uperez-unis/Ecualizador-de-6-bandas/Documentación/Ecualizador Reporte.pdf

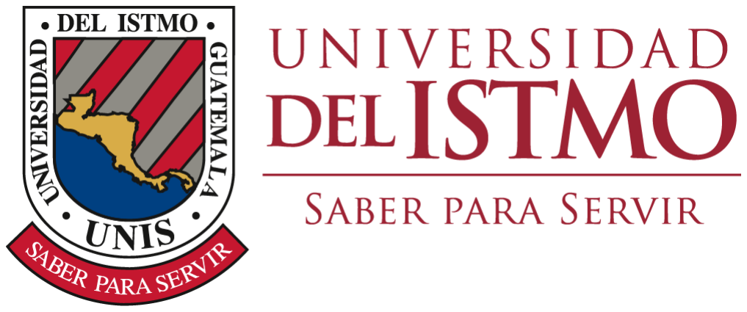
[picture p2: figure]

Microelectronic Devices
Pablo Oliva

# Ecualizador para piano eléctrico

Diego Alejandro Lemus Aldana Uriel Esaú Pérez Morales Diego Solís

## Contents

1 Introducción | 2
2 Instrumento: Piano Eléctrico | 2
3 Arquitectura del sistema | 2
4 Bandas de frecuencia | 2
5 Construcción de los Filtros Pasabanda | 3
6 Simulación en LTspice y Análisis del Ancho de Banda | 4
7 Diseño de Pasa-Bandas Sallen Key | 6
8 Determinación de límites de ganancia del sistema | 8
9 Diseño de sumador inversor para ±12 dB | 10
10 Simulación de sumador inversor en LTspice | 13

## 1 Introducción

El presente proyecto consiste en el diseño e implementación de un ecualizador analógico de seis bandas, desarrollado específicamente para un piano eléctrico. El sistema permite la amplificación o atenuación independiente de cada rango de frecuencia, con el objetivo de moldear el timbre del instrumento según las necesidades del intérprete.
La arquitectura del sistema se divide en cuatro etapas principales. La primera corresponde a la etapa de acople con el instrumento, implementada mediante un seguidor de voltaje para garantizar alta impedancia de entrada y evitar la pérdida de señal. La segunda etapa está compuesta por seis filtros pasabanda, construidos a partir de la combinación de filtros pasa-altas y pasa-bajas de segundo orden utilizando la topología Sallen-Key [1]. Posteriormente, las señales filtradas son sumadas en una etapa de amplificación tipo sumador, que permite el control individual de ganancia por banda. Finalmente, la señal procesada es enviada a una etapa de potencia encargada de excitar el sistema de salida.

## 2 Instrumento: Piano Eléctrico

## 3 Arquitectura del sistema

El ecualizador diseñado se compone de cuatro etapas funcionales claramente definidas, las cuales permiten el procesamiento progresivo de la señal desde su acople con el instrumento hasta su entrega final a la etapa de potencia.

1. Etapa de acople (Buffer de entrada). Implementada mediante un seguidor de voltaje, esta etapa proporciona alta impedancia de entrada y baja impedancia de salida, evitando la carga del instrumento y preservando la integridad de la señal original.
2. Etapa de filtrado. Cada banda del ecualizador se construye a partir de la cascada de un filtro pasa-altas y un filtro pasa-bajas de segundo orden, ambos implementados mediante la topología Sallen-Key. Esta configuración permite obtener un filtro pasabanda de cuarto orden para cada rango de frecuencia definido.
3. Etapa de control de ganancia. Las salidas de cada banda son enviadas a un circuito sumador activo, donde se implementa el control independiente de atenuación o amplificación mediante potenciómetros. En esta etapa también se incorpora el control general de volumen del sistema.
4. Etapa de potencia. Finalmente, la señal procesada es aplicada a una etapa de potencia basada en transistores BJT en configuración clase AB, permitiendo la entrega adecuada de corriente hacia la carga de salida (bocina 8 ohm).

## 4 Bandas de frecuencia

El espectro útil del piano eléctrico se concentra aproximadamente entre 40 Hz y 6 kHz. Para lograr un control tonal balanceado, se definieron seis bandas de frecuencia estratégicamente distribuidas, permitiendo modificar profundidad, cuerpo, claridad y brillo del instrumento sin generar solapamientos excesivos.

### 4.1 Definición inicial con criterio musical

Banda | Rango (Hz) | Justificación Técnica y Musical
1 | 40 – 80 | Controla la profundidad de las notas graves. Influye en la sensación de peso y potencia del instrumento. Un exceso puede generar saturación o sonido poco definido.
2 | 80 – 200 | Región del cuerpo principal del piano. Permite ajustar calidez y evitar efecto “boomy”.
3 | 200 – 500 | Zona crítica donde puede aparecer efecto de sonido “en-cajonado”. Un ajuste adecuado mejora la claridad.
4 | 500 – 1500 | Determina la definición y presencia del instrumento en mezcla. Fundamental para inteligibilidad.
5 | 1500 – 3000 | Contiene el ataque del martillo. Ajusta articulación y percepción de detalle.
6 | 3000 – 8000 | Controla brillo y armónicos superiores. Aporta claridad y aire al sonido.

Table 1: Rangos de frecuencia definidos con criterio musical.

### 4.2 Frecuencia central calculada (media geométrica)

En filtros pasa-banda, la frecuencia central se define como:

f0 =

p
fLfH. | (1)
Banda | fL (Hz) | fH (Hz) | f0 = fLfH (Hz)
1 | 40 | 80 | 56.6 ≈ 57
2 | 80 | 200 | 126.5 ≈ 127
3 | 200 | 500 | 316.2 ≈ 316
4 | 500 | 1500 | 866.0 ≈ 886
5 | 1500 | 3000 | 2121.3 ≈ 2121
6 | 3000 | 8000 | 4899 ≈ 4900

√

Table 2: Frecuencias centrales calculadas mediante media geométrica.

## 5 Construcción de los Filtros Pasabanda

Cada banda del ecualizador se implementa mediante la combinación de tres bloques principales:

- Filtro pasa-altas de segundo orden (HP2).
- Filtro pasa-bajas de segundo orden (LP2).
- Etapa de amplificación con control de ganancia.

Los filtros HP2 y LP2 se conectan en configuración en cascada, de modo que la salida del filtro pasa-altas alimenta directamente la entrada del filtro pasa-bajas. Esta configuración genera un filtro pasabanda equivalente de cuarto orden.
Dado que cada etapa es de segundo orden, el sistema presenta una pendiente de atenuación de aproximadamente −40 dB/dec tanto en la región inferior como en la superior fuera de la banda de paso, proporcionando una adecuada selectividad para el control independiente de cada rango del ecualizador.
Para el diseño de cada etapa se adopta una respuesta Butterworth de segundo orden, caracterizada por el siguiente factor de calidad:
Q ≈ 0.707 | (2)

Este valor garantiza una respuesta de magnitud máximamente plana en la banda de paso, sin ondulaciones y con una atenuación de −3 dB en la frecuencia de corte [2].
La ganancia de las etapas de filtrado será unitaria (K = 1), de modo que el control de nivel por banda se realice en una etapa independiente posterior al filtrado.

## 6 Simulación en LTspice y Análisis del Ancho de Banda

### 6.1 Caso inicial: 1 octava (40–80 Hz)

Para la primera banda se establecieron:

fL = 40 Hz, | fH = 80 Hz. | (3)

Al realizar la simulación en LTSpice se observó que la magnitud máxima del pasabanda no alcanzaba 0 dB, sino aproximadamente −1.78 dB.

### 6.2 Análisis individual de cada etapa en la frecuencia central

Para esta banda:

f0 =

√
40 · 80 = 56.6 Hz. | (4)

Al evaluar cada filtro por separado en f0, se obtuvo:

- Filtro pasa-altas: −0.917 dB
- Filtro pasa-bajas: −0.862 dB

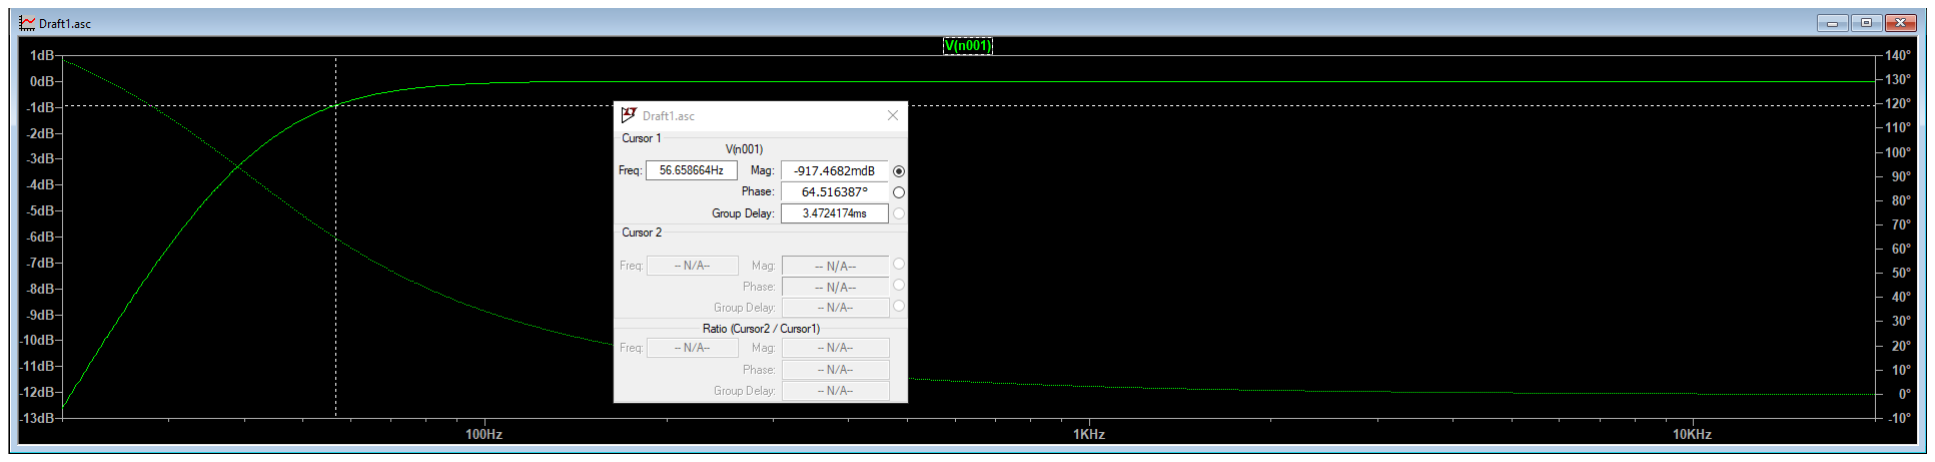
[picture p3: figure]

Figure 1: Respuesta en frecuencia del filtro pasa-altas en f0 = 56.6 Hz.

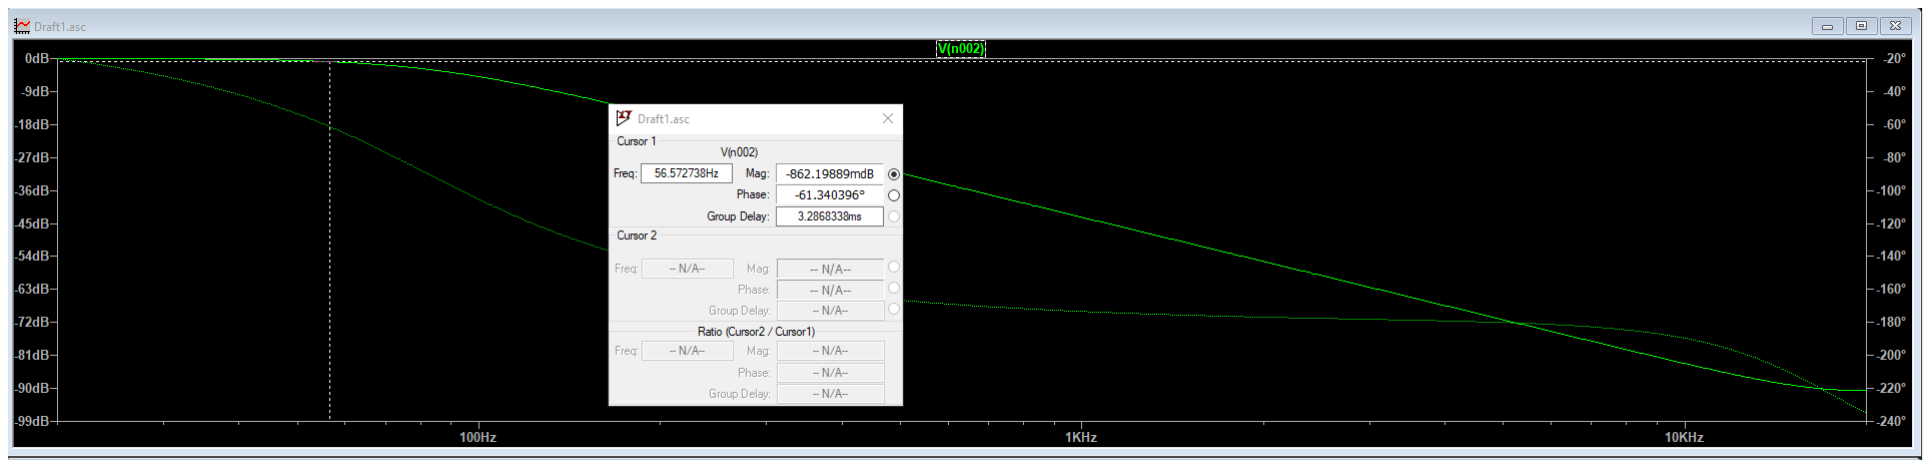
[picture p4: figure]

Figure 2: Respuesta en frecuencia del filtro pasa-bajas en f0 = 56.6 Hz.

Dado que ambas etapas se encuentran en cascada:

Htotal(jω) = HHP (jω) · HLP (jω). | (5)

Al expresarse en decibeles, el producto en magnitud se convierte en una suma logarítmica, por lo que:

Gtotal ≈ −0.917 dB + (−0.862 dB) ≈ −1.78 dB. | (6)

### 6.3 Corrección mediante 2 octavas

Para aumentar la separación entre frecuencias de corte, se utilizó un ancho de banda de dos octavas:

fL =

f0
2
, | fH = 2f0. | (7)

Con f0 ≈ 57 Hz:

fL = 28.3 Hz, | fH = 113.1 Hz. | (8)
Parámetro | Caso 1 octava | Caso 2 octavas
fL (Hz) | 40 | 28.5
fH (Hz) | 80 | 114
f0 (Hz) | 56.6 | 57

Table 3: Comparación de frecuencias para 1 octava vs 2 octavas (Banda 1).

Con esta configuración, la frecuencia central se ubica más lejos de las regiones de transición de ambas etapas, reduciendo la atenuación observada a aproximadamente −0.45 dB.

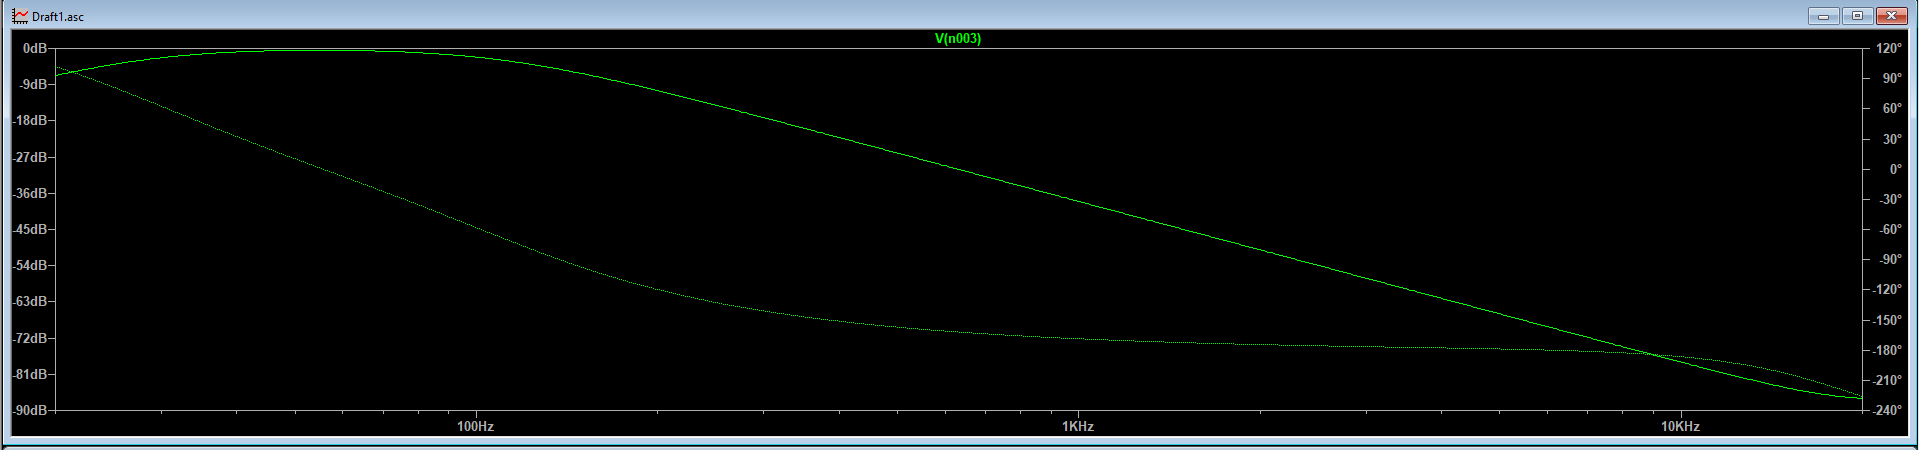
[picture p5: figure]

Figure 3: Respuesta del filtro pasa-banda utilizando un ancho de dos octavas.

A partir de este resultado, la misma estrategia será aplicada al diseño de las bandas restantes del ecualizador.

### 6.4 Frecuencias de corte calculadas para un ancho de dos octavas

Con el objetivo de aumentar la separación entre las frecuencias de corte y reducir la atenuación en la frecuencia central, se redefinió el ancho de banda utilizando dos octavas alrededor de f0.
Las nuevas frecuencias de corte se calcularon mediante:

fL =

f0
2
, | fH = 2f0. | (9)

De esta manera, la frecuencia central permanece constante, pero se incrementa la distancia relativa respecto a las regiones de transición de cada etapa.
Los valores obtenidos para cada banda se presentan en la Tabla 4.
Banda | fL (Hz) | fH (Hz) | f0 (Hz)
1 | 28.5 | 114 | 57
2 | 63.5 | 254 | 127
3 | 158 | 632 | 316
4 | 443 | 1772 | 886
5 | 1060.5 | 4242 | 2121
6 | 2450 | 9800 | 4900

Table 4: Frecuencias de corte calculadas utilizando un ancho de dos octavas alrededor de f0.

Estos valores serán utilizados para el diseño de los filtros pasa-altas (HP2) y pasa-bajas (LP2) correspondientes a cada banda del ecualizador.

## 7 Diseño de Pasa-Bandas Sallen Key

En las siguientes figuras se presentan las estructuras correspondientes a los filtros pasa-altas (HP2) y pasa-bajas (LP2) de segundo orden implementados mediante la topología Sallen-Key, para llevar a cabo la construcción de cada banda del ecualizador.

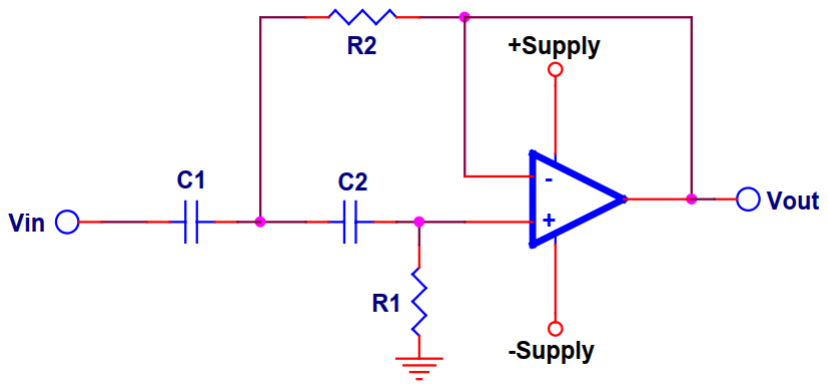
[picture p6: figure]

Figure 4: Estructura Sallen-Key para filtro pasa-altas de segundo orden.

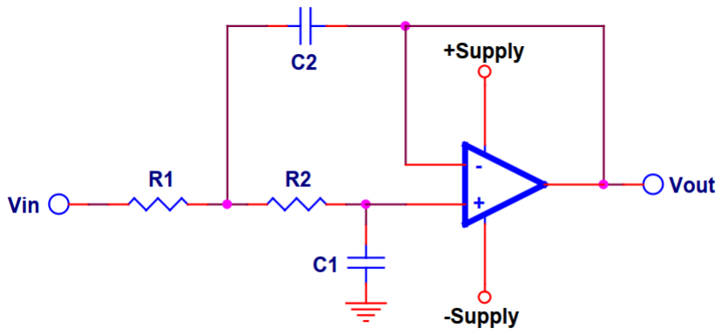
[picture p7: figure]

Figure 5: Estructura Sallen-Key para filtro pasa-bajas de segundo orden.

A partir de las frecuencias de corte fL y fH presentadas en la Tabla 4, se configuró cada filtro con una respuesta Butterworth de segundo orden (Q = 0.707) y ganancia unitaria (K = 1).
Con estos parámetros, se procedió al cálculo de los valores de los componentes pasivos (resistencias y capacitores) utilizando la herramienta de diseño Okawa-denshi [3].

### 7.1 Valores Calculados

## Banda 1 (57 Hz)

Componente | HP2 | LP2
R1 | 3.9 kΩ | 27 kΩ
R2 | 8.2 kΩ | 16 kΩ
C1 | 1 uF | 0.1 uF
C2 | 1 uF | 0.047 uF

Table 5: Valores de componentes para los filtros HP2 y LP2 de la Banda 1.

## Banda 2 (127 Hz)

Componente | HP2 | LP2
R1 | 18 kΩ | 12 kΩ
R2 | 36 kΩ | 6.8 kΩ
C1 | 0.1 µF | 0.1 µF
C2 | 0.1 µF | 0.047 µF

Table 6: Valores de componentes para la Banda 2 (HP2 y LP2).

## Banda 3 (316 Hz)

Componente | HP2 | LP2
R1 | 6.8 kΩ | 47 kΩ
R2 | 15 kΩ | 30 kΩ
C1 | 0.1 µF | 0.01 µF
C2 | 0.1 µF | 0.0047 µF

Table 7: Valores de componentes para la Banda 3 (HP2 y LP2).

## Banda 4 (886 Hz)

Componente | HP2 | LP2
R1 | 24 kΩ | 16 kΩ
R2 | 51 kΩ | 10 kΩ
C1 | 0.01 µF | 0.01 µF
C2 | 0.01 µF | 0.0047 µF

Table 8: Valores de componentes para la Banda 4 (HP2 y LP2).

## Banda 5 (2121 Hz)

Componente | HP2 | LP2
R1 | 11 kΩ | 6.8 kΩ
R2 | 22 kΩ | 4.3 kΩ
C1 | 0.01 µF | 0.01 µF
C2 | 0.01 µF | 0.0047 µF

Table 9: Valores de componentes para la Banda 5 (HP2 y LP2).

## Banda 6 (4243 Hz)

Componente | HP2 | LP2
R1 | 4.7 kΩ | 30 kΩ
R2 | 9.1 kΩ | 18 kΩ
C1 | 0.01 µF | 0.001 µF
C2 | 0.01 µF | 470 pF

Table 10: Valores de componentes para la Banda 6 (HP2 y LP2).

### 7.2 Simulación de las 6 bandas en conjunto

Una vez diseñadas todas las etapas individuales, se implementaron las seis ramas en LTSpice utilizando el modelo del TL081. La respuesta en frecuencia fue obtenida mediante análisis AC, activando simultáneamente los seis filtros pasa-banda.

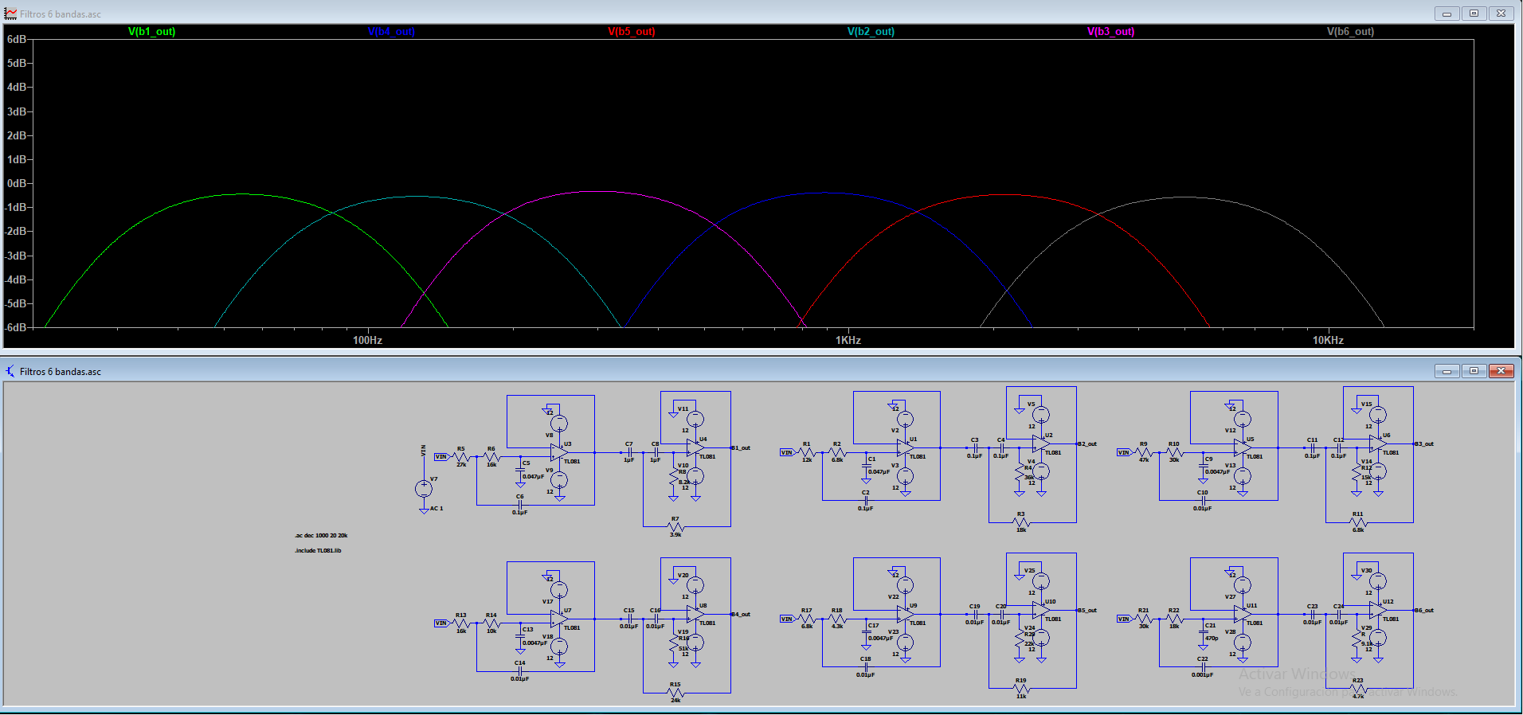
[picture p8: figure]

Figure 6: Respuesta en frecuencia en LTSpice de las seis bandas pasa-banda activas simul- táneamente.

## 8 Determinación de límites de ganancia del sistema

### 8.1 Selección de bocina

Se seleccionó una bocina de 8 Ω y 35W RMS con diámetro de 4 pulgadas, ya que ofrece un buen balance entre potencia, tamaño y facilidad de diseño.
La impedancia de 8 Ω permite trabajar con una etapa de potencia clase AB sin exigir corrientes excesivas a los transistores, lo que simplifica el diseño y reduce riesgos de sobrecalentamiento.
En cuanto a la potencia, los 35W RMS no se utilizarán al máximo, sino que brindan un margen de seguridad para evitar saturación o daño ante picos de la señal del piano eléctrico. En la práctica, el sistema operará por debajo de ese límite, asegurando un funcionamiento estable y seguro.
Finalmente, el tamaño de 4 pulgadas permite una reproducción más completa del sonido en comparación con bocinas más pequeñas, especialmente en frecuencias medias y graves, lo cual es importante para lograr un sonido más natural del instrumento.

### 8.2 Voltaje máximo de bocina

Para evitar dañar la bocina, se limita el voltaje máximo que puede entregarse a la carga. Dada una bocina de R = 8 Ω y potencia nominal P = 35 W, el voltaje máximo permisible en valor eficaz se obtiene a partir

de:

P =

V

2
RMS
R

(10)

Despejando:

VRMS,max =

√
P · R =

√
35 · 8 ≈ 16.7 VRMS | (11)

Este valor establece el límite de salida del sistema (antes de la etapa de potencia) para no exceder la potencia nominal de la bocina. Con este límite, la ganancia máxima permisible del sumador depende del voltaje eficaz máximo que entrega el piano eléctrico a la entrada del ecualizador, Vin,RMS:

Av,max =

Vout,RMS,max

Vin,RMS,max

=

16.7

Vin,RMS,max

(12)

Por ejemplo, si se asume un nivel típico de salida de línea del piano de Vin,RMS,max ≈ 1 VRMS, entonces:

Av,max ≈

16.7
1
| = 16.7 | (13)

En decibeles:
Av,max(dB) = 20 log10(16.7) ≈ 24.4 dB | (14)

Por lo tanto, para garantizar que la bocina no sea sobreexcitada, la etapa sumadora (y el control de volumen general) debe diseñarse de modo que la ganancia total no exceda aproximadamente 16.7× (24.4 dB) cuando la señal de entrada alcance su nivel máximo.

### 8.3 Margen de ganancia respecto a ecualizadores típicos

En ecualizadores gráficos comerciales, cada banda suele contar con un control graduado en dB, donde la posición neutra corresponde a 0 dB (ganancia 1). Típicamente, la ganancia máxima por banda es de +12 dB, lo cual equivale aproximadamente a una ganancia lineal de 4 (y simétricamente −12 dB corresponde a reducir la señal a un factor 4)[4]..
La relación entre ganancia en dB y ganancia lineal está dada por:

Av = 10

| GdB
| 20 | (15)

Por lo tanto, para +12 dB:
Av(12 dB) = 10 ¹²
| 20 ≈ 3.98 ≈ 4 | (16)

En este proyecto, el límite superior de ganancia total antes de exceder la potencia nominal de la bocina (35 W en 8 Ω) se estimó en aproximadamente 24.4 dB (ganancia ≈ 16.7). En consecuencia, el realce típico de +12 dB por banda está muy por debajo del umbral impuesto por la bocina, dejando un margen aproximado de:
24.4 dB − 12 dB = 12.4 dB | (17)

lo cual equivale a un factor adicional en voltaje de:

10

12.4
20 | ≈ 4.17 | (18)

Esto indica que, desde el punto de vista del límite de potencia de la bocina, un rango típico de ecualización de +12 dB representa una amplificación considerablemente menor (ganancia ≈ 4) que la máxima teórica permitida por la carga (ganancia ≈ 16.7), proporcionando margen de operación.

## 9 Diseño de sumador inversor para ±12 dB

### 9.1 Función de transferencia

La etapa sumadora se implementa con un amplificador operacional en configuración inversora. Para N entradas, cada una conectada mediante una resistencia Rin,k, la salida viene dada por:

Vo = −Rf

X

N

k=1

Vk

Rin,k !
(19)

En el caso de resistencias de entrada iguales (Rin,k = Rin), se obtiene:

Vo = −

Rf

Rin

(V1 + V2 + · · · + VN ) | (20)

Por tanto, la ganancia de cada canal hacia la salida está determinada por:

Av = −

Rf

Rin

(21)

### 9.2 Ajuste de ganancia mediante potenciómetro y resistencia en serie

La ganancia en magnitud de un amplificador inversor está dada por:

Av = −

Rf

Rin

(22)

Si se utilizara únicamente un potenciómetro como resistencia de entrada, al llevarlo a su valor mínimo (Rp → 0 Ω) se tendría:

Rin → 0 | ⇒ | |Av| → ∞

lo cual provocaría saturación del amplificador operacional.
Para evitar este comportamiento, se coloca una resistencia fija Rs en serie con el potenciómetro Rp, garantizando un valor mínimo de resistencia de entrada:
Rin = Rs + Rp | (23)

donde Rp varía entre 0 y 50 kΩ.
La ganancia del circuito queda entonces:

Av = −

| | Rf
Rs + Rp

(24)

### 9.3 Determinación de Rs y Rf para ±12 dB

Se desea que el rango de ajuste sea:

±12 dB

Recordando que:

|Av| = 10

| | dB
20 | (25)

Para +12 dB:

Amax = 10¹²/20 = 3.981 | (26)

Para −12 dB:

Amin = 10⁻¹²/20 = 0.251 | (27)

Por lo tanto:

0.251 ≤ |Av| ≤ 3.981

Condición de ganancia máxima

La ganancia máxima ocurre cuando:

Rp = 0

|Amax| =

Rf
Rs

(28)

Imponiendo |Amax| = 3.981:

Rf
Rs
= 3.981 | (29)

Despejando:

Rf = 3.981 Rs | (30)

Condición de ganancia mínima

La ganancia mínima ocurre cuando:

Rp = 50 kΩ

|Amin| =

Rf
Rs + 50k

(31)

Imponiendo |Amin| = 0.251:

Rf
Rs + 50k
= 0.251 | (32)

Sustituyendo Rf = 3.981 Rs:

3.981 Rs
Rs + 50k
= 0.251 | (33)

Resolviendo:

3.981Rs = 0.251(Rs + 50k) | (34)
3.981Rs = 0.251Rs + 12.55k | (35)
3.730Rs = 12.55k | (36)
Rs = 3.366 kΩ | (37)

Cálculo explícito de Rf

Sustituyendo el valor obtenido de Rs en la relación:

Rf = 3.981 Rs | (38)
Rf = 3.981 × 3.366 kΩ | (39)
Rf = 13.40 kΩ | (40)

Valores comerciales recomendados

Rs = 3.3 kΩ

Rf = 13.3 kΩ

### 9.4 Verificación de ganancia con valores comerciales

Con Rf = 13.3 kΩ, Rs = 3.3 kΩ y Rp ∈ [0, 50] kΩ, la ganancia en magnitud es:

|Av| =

Rf
Rs + Rp

Ganancia máxima (Rp = 0)

|Av,max| =

13.3 kΩ
3.3 kΩ + 0Ω = 4.03 | ⇒ | Av,max(dB) = 20 log10(4.03) ≈ 12.12 dB | (41)

Ganancia mínima (Rp = 50 kΩ)

|Av,min| =

13.3 kΩ
3.3 kΩ + 50 kΩ
= 0.2495 | ⇒ | Av,min(dB) = 20 log10(0.2495) ≈ −12.06 dB | (42)

### 9.5 Valor de Rp para 0 dB

Para 0 dB se requiere |Av| = 1:

1 =

Rf
Rs + Rp
⇒ | Rf = Rs + Rp | ⇒ | Rp = Rf − Rs | (43)
Rp = 13.3 kΩ − 3.3 kΩ = 10 kΩ | (44)

Por lo tanto, se observa que el punto correspondiente a 0 dB no se encuentra exactamente en la mitad del recorrido del potenciómetro, debido a que la ganancia depende de manera inversamente proporcional de la suma Rs + Rp, lo cual introduce una relación no lineal entre la posición mecánica del potenciómetro y el valor de ganancia obtenido.
Los valores seleccionados de Rf , Rs y el potenciómetro Rp serán implementados de manera uniforme en todas las bandas del ecualizador, garantizando así un comportamiento consistente en el rango de ajuste de ganancia del sistema.

## 10 Simulación de sumador inversor en LTspice

Con el objetivo de validar el comportamiento de la etapa sumadora inversora con control de ganancia por banda, se realizó una simulación AC en LTspice replicando los tres escenarios de interés correspondientes al rango típico de ecualización: realce máximo (+12 dB), ganancia unitaria (0 dB) y atenuación máxima (-12 dB).
El sumador se diseñó para un rango aproximado de ±12 dB, utilizando los siguientes valores comerciales:
- Resistencia de realimentación: Rf = 13.3 kΩ
- Resistencia serie mínima: Rs = 3.3 kΩ
- Potenciómetro por banda: Rp ∈ [0, 50] kΩ

Para replicar los tres casos extremos y el punto neutro:

- +12 dB (realce máximo): Rp = 0 ⇒ Rin = Rs
- -12 dB (atenuación máxima): Rp = 50 kΩ ⇒ Rin = Rs + 50 kΩ
- 0 dB (ganancia unitaria): se impone |Av| = 1 ⇒ Rf = Rs + Rp, por lo que:
Rp,0dB = Rf − Rs = 13.3 kΩ − 3.3 kΩ = 10 kΩ. | (45)

La Figura 7 muestra la respuesta en frecuencia obtenida para los tres valores de Rp, evidenciando que la etapa sumadora permite implementar el control de ganancia por banda dentro del rango deseado. Además, se incluyen las seis salidas provenientes de las bandas del ecualizador, lo cual permite observar el comportamiento del sistema al sumar las señales filtradas.

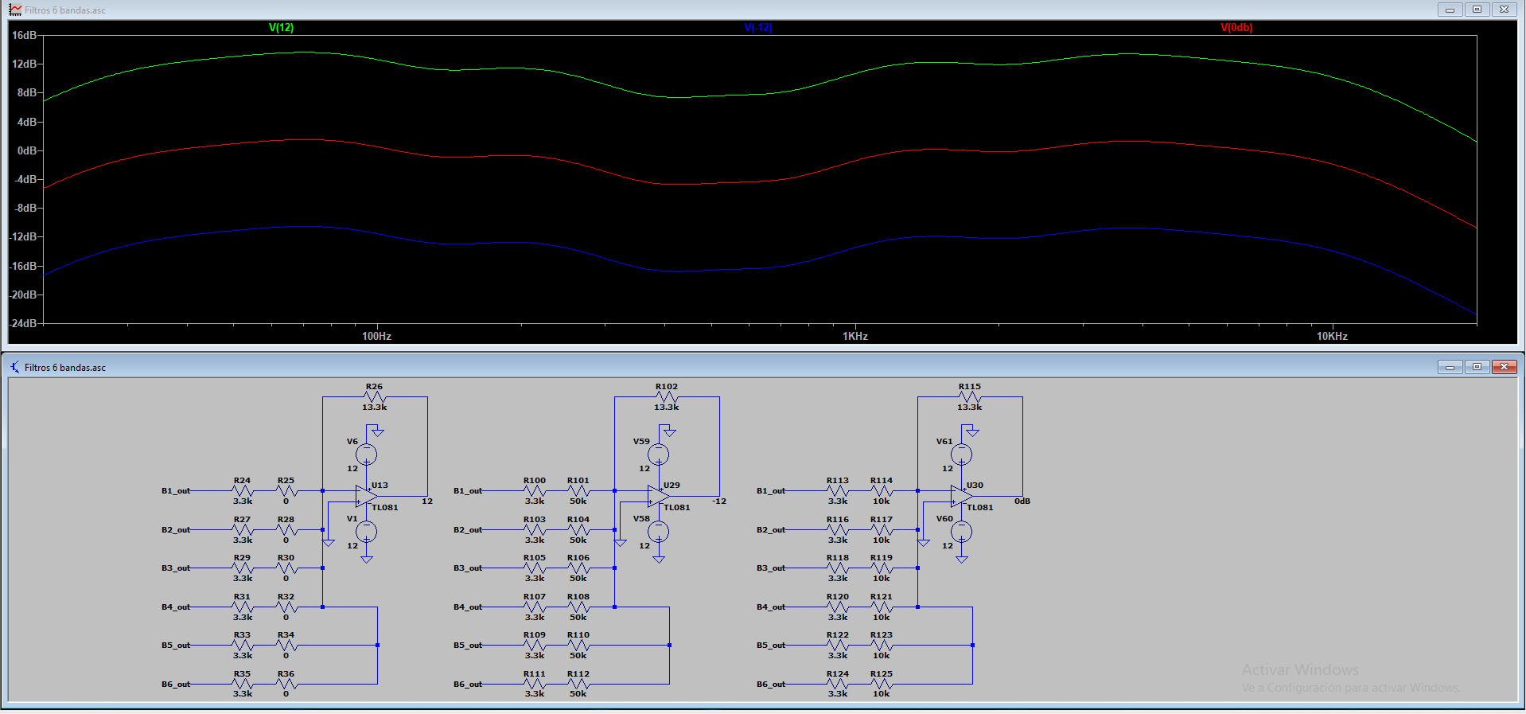
[picture p9: figure]

Figure 7: Simulación en LTspice del sumador inversor para los casos de −12 dB, 0 dB y +12 dB, utilizando Rf = 13.3 kΩ, Rs = 3.3 kΩ y Rp variable.

## References

[1] CARTER, Bruce. Filter Design in Thirty Seconds. Dallas: Texas Instruments, 2001. Application Report SLOA093.
[2] J. Karki, Active Low-Pass Filter Design, Texas Instruments, Application Report SLOA049D, Jul. 2000, rev. Feb. 2023.
[3] OKAWA Electric Design. Filter Design and Analysis Tool. Disponible en: http://sim.okawa-denshi.jp/en/Fkeisan.htm. (http://sim.okawa-denshi.jp/en/Fkeisan.htm) [Consulta: 24 febrero 2026].
[4] MIYARA, Federico. Ecualizadores. Facultad de Ciencias Exactas, Ingeniería y Agrimensura, Universidad Nacional de Rosario. Disponible en: https://www.fceia.unr.edu.ar/acustica/audio/ecualizadores.pdf. (https://www.fceia.unr.edu.ar/acustica/audio/ecualizadores.pdf) [Consulta: 25 febrero 2026].
