uperez-unis/Ecualizador-de-6-bandas/Simulación LTspice/Ecualizador.asc

C1: cap; 0.047µ
C2: cap; 0.1µ
C3: cap; 0.1µ
C4: cap; 0.1µ
C5: cap; 0.047µ
C6: cap; 0.1µ
C7: cap; 0.1µ
C8: cap; 0.1µ
C9: cap; 0.047µ
C10: cap; 0.1µ
C11: cap; 1µ
C12: cap; 1µ
C13: cap; 0.047µ
C14: cap; 0.1µ
C15: cap; 0.1µ
C16: cap; 0.1µ
C17: cap; 0.0047µ
C18: cap; 0.01µ
C19: cap; 0.1µ
C20: cap; 0.1µ
C21: cap; 0.0047µ
C22: cap; 0.01µ
C23: cap; 0.01µ
C24: cap; 0.01µ
C25: cap; 470p
C26: cap; 0.001µ
C27: cap; 0.01µ
C28: cap; 0.01µ
C29: cap; 470p
C30: cap; 0.001µ
C31: cap; 0.01µ
C32: cap; 0.01µ
R1: res; 30k
R2: res; 47k
R3: res; 18k
R4: res; 36k
R5: res; 20k
R6: res; 33k
R7: res; 24k
R8: res; 51k
R9: res; 15k
R10: res; 24k
R11: res; 3.6k
R12: res; 7.5k
R13: res; 5.6k
R14: res; 9.1k
R15: res; 15k
R16: res; 27k
R17: res; 22k
R18: res; 36k
R19: res; 5.6k
R20: res; 11k
R21: res; 9.1k
R22: res; 15k
R23: res; 22k
R24: res; 47k
R25: res; 36k
R26: res; 62k
R27: res; 9.1k
R28: res; 18k
R29: res; 15k
R30: res; 24k
R31: res; 3.6k
R32: res; 7.5k
R33: res; 27k
R34: res; 6.8k
R35: res; 100k
R36: res; 6.8k
R37: res; 100k
R38: res; 6.8k
R39: res; 100k
R40: res; 6.8k
R41: res; 100k
R42: res; 6.8k
R43: res; 100k
R44: res; 6.8k
R45: res; 100k
R46: res; 27k
R47: res; 6.8k
R48: res; 0
R49: res; 6.8k
R50: res; 0
R51: res; 6.8k
R52: res; 0
R53: res; 6.8k
R54: res; 0
R55: res; 6.8k
R56: res; 0
R57: res; 6.8k
R58: res; 0
R59: res; 27k
R60: res; 6.8k
R61: res; 20.2k
R62: res; 6.8k
R63: res; 20.2k
R64: res; 6.8k
R65: res; 20.2k
R66: res; 6.8k
R67: res; 20.2k
R68: res; 6.8k
R69: res; 20.2k
R70: res; 6.8k
R71: res; 20.2k
U1: ADTL084
U2: ADTL084
U3: ADTL084
U4: ADTL084
U5: ADTL084
U6: ADTL084
U7: ADTL084
U8: ADTL084
U9: ADTL084
U10: ADTL084
U11: ADTL084
U12: ADTL084
U13: ADTL084
U14: ADTL084
U15: ADTL084
U16: ADTL084
U17: ADTL084
U18: ADTL084
U19: ADTL084
V1: voltage; ""; AC 1
V2: voltage; 12
V3: voltage; 12
V4: voltage; 12
V5: voltage; 12
V6: voltage; 12
V7: voltage; 12
V8: voltage; 12
V9: voltage; 12
V10: voltage; 12
V11: voltage; 12
V12: voltage; 12
V13: voltage; 12
V14: voltage; 12
V15: voltage; 12
V16: voltage; 12
V17: voltage; 12
V18: voltage; 12
V19: voltage; 12
V20: voltage; 12
V21: voltage; 12
V22: voltage; 12
V23: voltage; 12
V24: voltage; 12
V25: voltage; 12
V26: voltage; 12
V27: voltage; 12
V28: voltage; 12
V29: voltage; 12
V30: voltage; 12
V31: voltage; 12
V32: voltage; 12
V33: voltage; 12
V34: voltage; 12
V35: voltage; 12
V36: voltage; 12
V37: voltage; 12
V38: voltage; 12
V39: voltage; 12
Named nets: 0, Vout6dB, Vout3dB, V1, VoutB1, VoutB2, VoutB3, VoutB4, VoutB5, VoutB6, VoutSum-12dB, VoutSum+12dB, VoutSum0dB
.ac dec 1000 20 20k
63hz 0 octavas
63hz 1 octavas
63hz 2 octavas
160hz 2 octavas
400hz 2 octavas
1khz 2 octavas
2.5khz 2 octavas
6.3khz 2 octavas
